termite-labs/termite-labs-vibratory-tumbler/assets/instrcutions_base_with_springs.jpeg

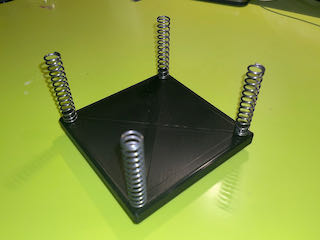
assets/instrcutions_base_with_springs.jpeg
