termite-labs/termite-labs-vibratory-tumbler/assets/instrcutions_remove_weight.jpeg

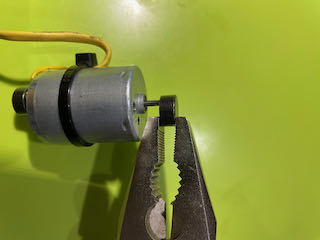
assets/instrcutions_remove_weight.jpeg
