termite-labs/termite-labs-vibratory-tumbler/assets/instrcutions_remove_weight_done.jpeg

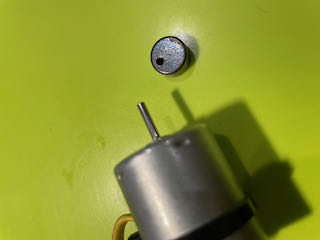
assets/instrcutions_remove_weight_done.jpeg
