termite-labs/termite-labs-vibratory-tumbler/assets/parts/final.spring.jpg

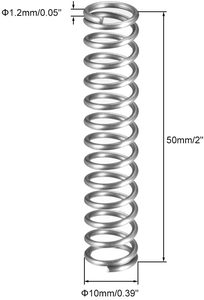
assets/parts/final.spring.jpg
