termite-labs/termite-labs-vibratory-tumbler/assets/parts/final.wire.jpg

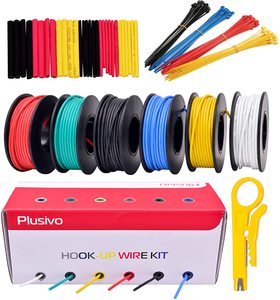
assets/parts/final.wire.jpg
