termite-labs/termite-labs-vibratory-tumbler/TVT-Micro-0.5-Frame-Top.stl

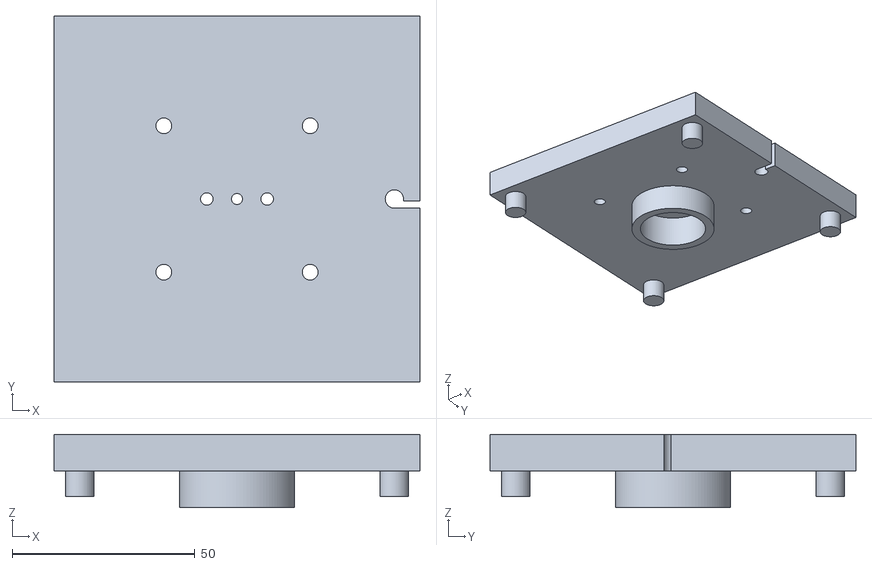
[picture p72: CAD file, 2020-12-21]
TVT-Micro-0.5-Frame-Top.stl
100.0 x 100.0 x 20.0
