termite-labs/termite-labs-vibratory-tumbler/TVT-Micro-0.5-Weight-B.stl

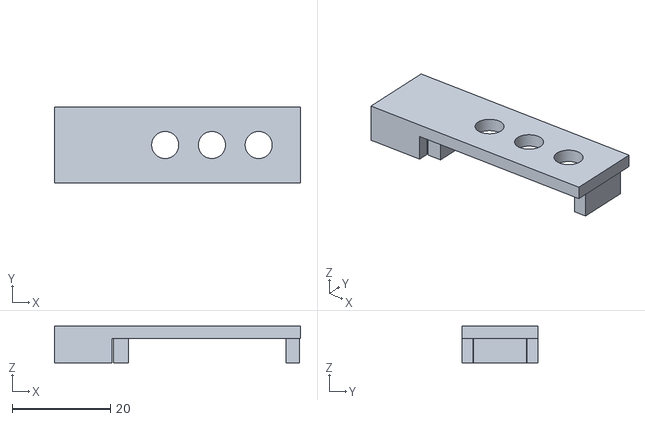
[picture p73: CAD file, 2020-12-17]
TVT-Micro-0.5-Weight-B.stl
50.0 x 15.4 x 7.50
