termite-labs/termite-labs-vibratory-tumbler/TVT-Micro-0.5-Frame-Base.stl

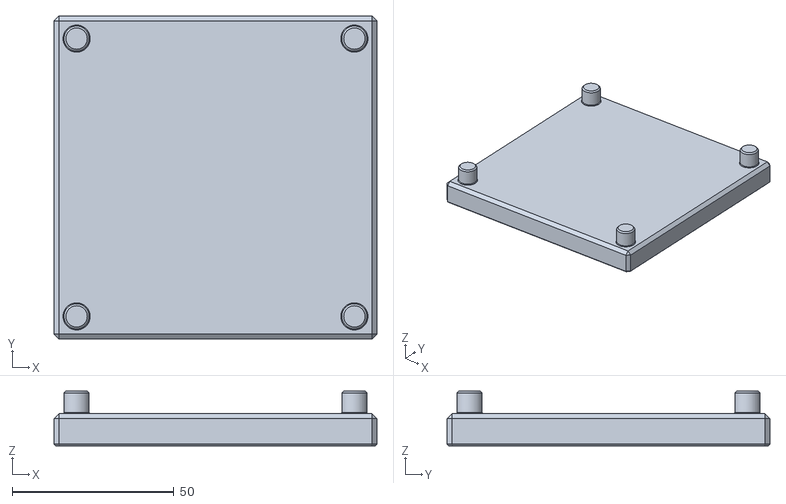
[picture p74: CAD file, 2020-12-17]
TVT-Micro-0.5-Frame-Base.stl
100.0 x 100.0 x 17.0
