termite-labs/termite-labs-vibratory-tumbler/TVT-Micro-0.5-Weight-A.stl

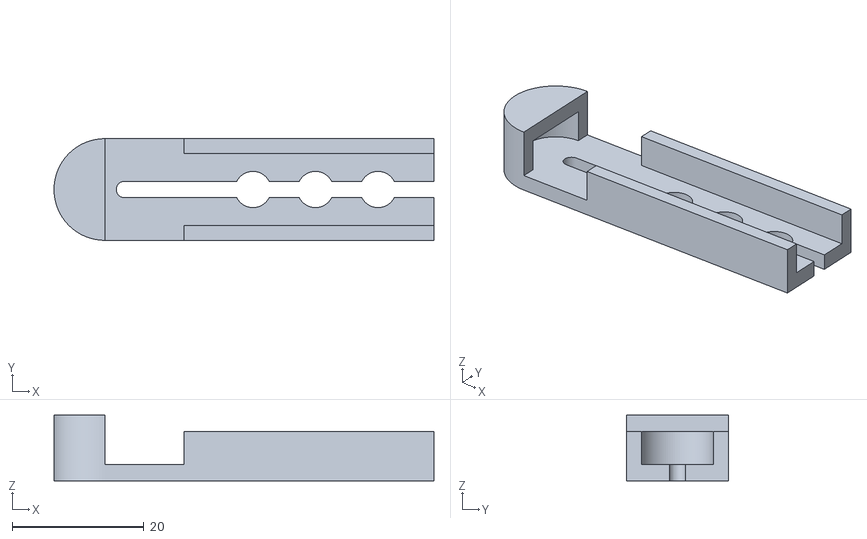
[picture p75: CAD file, 2020-12-17]
TVT-Micro-0.5-Weight-A.stl
57.7 x 15.4 x 10.0
