termite-labs/termite-labs-vibratory-tumbler/assets/instructions/final.motor_back.jpeg

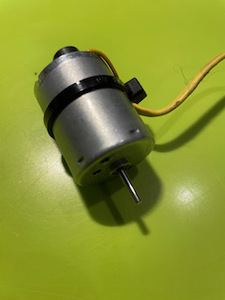
assets/instructions/final.motor_back.jpeg
