termite-labs/termite-labs-vibratory-tumbler/assets/instructions_ac-dc_adapter_plug_male_connector.jpeg

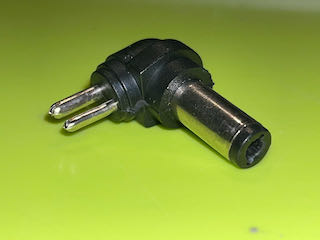
assets/instructions_ac-dc_adapter_plug_male_connector.jpeg
