termite-labs/termite-labs-vibratory-tumbler/assets/instructions_base_with_stripped_wires.jpeg

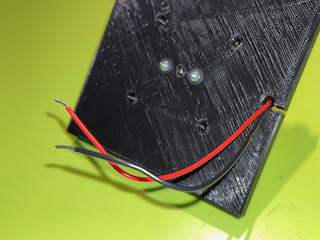
assets/instructions_base_with_stripped_wires.jpeg
