termite-labs/termite-labs-vibratory-tumbler/assets/instructions_m2_screws_with_washers.jpeg

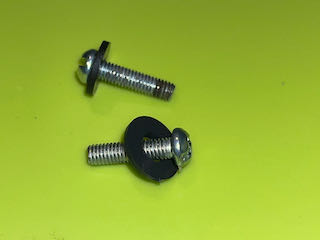
assets/instructions_m2_screws_with_washers.jpeg
