termite-labs/termite-labs-vibratory-tumbler/assets/instructions_motor_ready_to_solder.jpeg

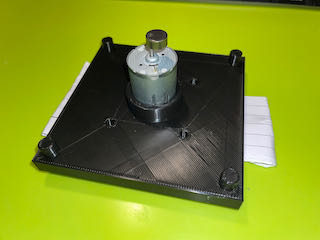
assets/instructions_motor_ready_to_solder.jpeg
