termite-labs/termite-labs-vibratory-tumbler/(threads)

Thread 2 (2020-12-26):

The motor screws get loose after a few hours of operation

mcaprari, 2020-12-26:
The vibrations cause the motor screws to become loose after a few hours of operation.

* The motor does not detach because the screws can't travel backwards enough.
* This causes additional noise because the motor is not perfectly snug in its socket.

soivegotaproject, 2025-01-05:
Best way to fix this issue would be to use threatlock on the bolts
