termite-labs/termite-labs-vibratory-tumbler/(commit log)

2020-12-17 added stl files
    [Vibratory Tumbler V1 - Frame Bottom.stl, Vibratory Tumbler V1 - Frame Top.stl, Vibratory Tumbler V1 - Weight Bottom.stl, Vibratory Tumbler V1 - Weight Top.stl]
2020-12-18 Improved readme and added STL thumbnails
    [Termite_Vibratory_Tumbler_Micro_V0.5-Frame_Base.stl, Termite_Vibratory_Tumbler_Micro_V0.5-Frame_Top.stl, Termite_Vibratory_Tumbler_Micro_V0.5-Weight_A.stl, Termite_Vibratory_Tumbler_Micro_V0.5-Weight_B.stl]
2020-12-18 More readme work
    [Termite_Vibratory_Tumbler_Micro_V0.5-Frame_Top.stl]
2020-12-18 Improved printing instructions
2020-12-19 New materials table
2020-12-21 More work on readme
    [TVT-Micro-0.5-Frame-Top.stl]
